SummittDweller/Motorized_MQTT_Blinds/README.md

# Motorized_MQTT_Blinds

This repository is to accompany my Motorized_MQTT_Blinds video:

IMAGE ALT TEXT HERE (https://www.youtube.com/watch?v=1O_1gUFumQM)

## Parts List
Stepper Motors: https://amzn.to/2D5rVsF

Stepper Drivers: https://amzn.to/2OZqW1W

NodeMCU: https://amzn.to/2I89xDF

12V Power Supply: https://amzn.to/2G2ZJrf

Buck Converter: https://amzn.to/2UsQ7jA

## 3D Printing

Download the correct STL file for your style of tilt rod

## Wiring Schematic

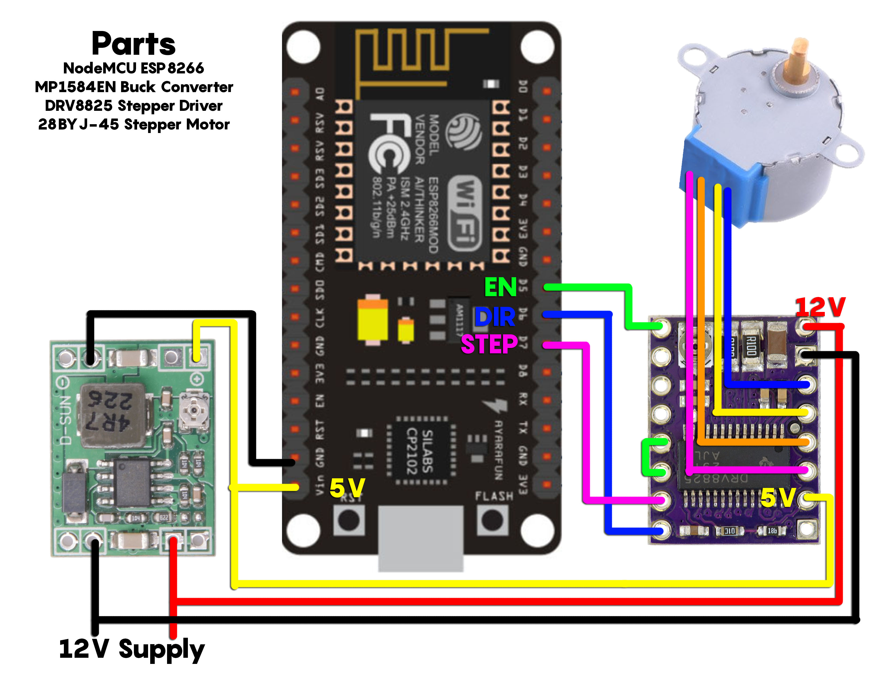
[picture p1: Alexa-Only/Motorized_MQTT_Blinds-Alexa_No_Hub/Schematic.jpg]


**Dont forget to cut the center trace on the stepper motor as shown in the youtube video**

## File setup

Fill out the entire USER CONFIGURATION section of the code.

You should leave "STEPS_TO_CLOSE" at 12 to start with.  It can be adjusted for your specific blinds

## Home Assistant YAML

Replace "BlindsMCU" with your MQTT_CLIENT_ID if you changed it in the file setup

```yaml
cover:
  - platform: mqtt
    name: "Motorized Blinds"
    command_topic: "BlindsMCU/blindsCommand"
    set_position_topic: "BlindsMCU/positionCommand"
    position_topic: "BlindsMCU/positionState"
    state_topic: "BlindsMCU/positionState"
    retain: true
    payload_open: "OPEN"
    payload_close: "CLOSE"
    payload_stop: "STOP"
    position_open: 0
    position_closed: 12
  ```

## Recommended Tools

Ender3 3d Printer: https://amzn.to/2GcznnZ

Dupont Crimper and Connector Set: https://amzn.to/2X1Oeap

## Alexa only support available in the releases tab of this repo!

# Additional Resources

## DRV8825 Stepper Motor Driver Chip
https://lastminuteengineers.com/drv8825-stepper-motor-driver-arduino-tutorial/

## Dupont Connector Guide
https://www.instructables.com/Make-a-Good-Dupont-Pin-Crimp-EVERY-TIME/

##  MQTT Server Creation
https://www.google.com/search?client=firefox-b-1-d&q=mqtt+server
https://www.home-assistant.io/docs/mqtt/broker/
https://learn.adafruit.com/set-up-home-assistant-with-a-raspberry-pi/raspberry-pi-server-setup
https://learn.adafruit.com/set-up-home-assistant-with-a-raspberry-pi/mqtt-setup

## Home Assistant Configuration
http://homeassistant.local:8123        -- My Home Assitant, an RPI B+ located in my office closet
https://www.home-assistant.io/getting-started/onboarding/

### NodeMCU (Arduino) Info

MAC Address of 1st NodeMCU:  84:CC:A8:82:DE:0A

**Attention!** Make sure you are using a micro-USB cable that supports _*data*_ as well as power!

Note that there are comm port issues with Big Sur that impact Arduino.  For more info see:
https://github.com/esp8266/Arduino/issues/7763 and the fix in https://forum.arduino.cc/index.php?topic=702144.0.

#### NodeMCU and Alexa
https://www.instructables.com/How-To-DIY-Home-Automation-With-NodeMCU-and-Amazon/    --not all that helpful
https://randomnerdtutorials.com/alexa-echo-with-esp32-and-esp8266/  --helped with libraries install

#### Now for the Resources
https://www.open-homeautomation.com/2016/06/10/program-an-esp8266-from-arduino-on-macos/
https://en.wikipedia.org/wiki/NodeMCU
https://www.instructables.com/How-to-Program-NodeMCU-on-Arduino-IDE/
https://github.com/nodemcu/nodemcu-firmware
https://medium.com/@bass.pj/nodemcu-esp8266-getting-started-with-arduino-on-macos-1cdc61565496
https://electrosome.com/esp8266-arduino-programming-led-blink/    -- LED blink test

From the Amazon.com product description...

Product description:
ESP8266 is a highly integrated chip designed for the needs of a new connected world. It offers a complete and self-contained Wi-Fi networking solution, allowing it to either host the application or to offload all Wi-Fi networking functions from another application processor.

Instruction & Steps of How to Use:

1. Download the Arduino IDE, the latest version.
2. Install the IDE
3. Set up your Arduino IDE as: Go to File->Preferences and copy the URL below to get the ESP board manager extensions: http://arduino.esp8266.com/stable/package_esp8266com_index.json Placing the http:// before the URL lets the Arduino IDE use it...otherwise it gives you a protocol error.
4. Go to Tools > Board > Board Manager> Type "esp8266" and download the Community esp8266 and install.
5. Set up your chip as:
Tools -> Board -> NodeMCU 1.0 (ESP-12E Module)
Tools -> Flash Size -> 4M (3M SPIFFS)
Tools -> CPU Frequency -> 80 Mhz
Tools -> Upload Speed -> 921600
Tools-->Port--> (whatever it is)
6. Download and run the 32 bit flasher exe at Github(Search for nodemcu/nodemcu-flasher/tree/master/ at Github) github.com/nodemcu/nodemcu-flasher/tree/master/Win32/Release Or download and run the 64 bit flasher exe at: github.com/nodemcu/nodemcu-flasher/tree/master/Win64/Release
7. In Arduino IDE, look for the old fashioned Blink program. Load, compile and upload.
8. Go to FILE> EXAMPLES> ESP8266> BLINK, it will start blinking.

### Control via Arduino Uno
https://www.makerguides.com/28byj-48-stepper-motor-arduino-tutorial/
https://www.seeedstudio.com/blog/2019/03/04/driving-a-28byj-48-stepper-motor-with-a-uln2003-driver-board-and-arduino/
https://lastminuteengineers.com/28byj48-stepper-motor-arduino-tutorial/

### Control via Raspberry Pi
https://www.aranacorp.com/en/control-a-stepper-with-raspberrypi/
http://www.scraptopower.co.uk/Raspberry-Pi/how-to-connect-stepper-motors-a-raspberry-pi
https://www.raspberrypi-spy.co.uk/2012/07/stepper-motor-control-in-python/
https://tutorials-raspberrypi.com/how-to-control-a-stepper-motor-with-raspberry-pi-and-l293d-uln2003a/

# Alexa ONLY Control... the GOOD Stuff

  - Lifted from https://github.com/thehookup/Motorized_MQTT_Blinds/releases/tag/Alexa_No_Hub

## Alexa Only with WiFi Manager

@thehookup thehookup released this on Apr 11, 2019 · 10 commits to master since this release

This release uses Amazon Alexa local control and WiFi Manager to configure and control your blinds. No other hub or device (other than a wifi router) is required for this version and there is no MQTT control.

This is a pre-compiled bin file to upload to a NodeMCU using the ESPEasy flashing tool (instructions below).

  Install Instructions:

      Download the ESPEasy Flashing tool here: https://github.com/letscontrolit/ESPEasy/releases/
      Extract the zip file from the above link to your computer
      Download the .bin file for this release and place it in the same folder as the ESPEasy flashing tool.
      Plug in your NodeMCU using a USB Cable
      Run FlashESP8266.exe
      Select this bin file (Alexa_Only_Blinds.bin) under the firmware dropdown and press "Flash"

  Setup Instructions:

      Connect to the "Blinds Setup" wifi access point that is being broadcast by your NodeMCU
      Enter your WiFi SSID and Password
      Enter the number of rotations required for your blinds to fully open/close (12 Recommended)
      Press save and wire your blinds as shown in the wiring diagram on the main page of this repository.

  **If you mess up your settings you can connect a wire between GND and D1 to clear the saved settings on the NodeMCU.
  If you have issues with discovery please try the "Blinds_CONFIGURE_Portal_Alexa_Core_2.3.bin" file

  Assets 4
  Alexa_Only_Blinds.bin
  408 KB
  Blinds_CONFIGURE_Portal_Alexa_Core_2.3.bin
  358 KB
  Source code (zip)
  Source code (tar.gz)
