SummittDweller/Motorized_MQTT_Blinds/Cat5-Cable-Colors.md

# Cat5 Cable Colors

In my version of the project the Cat5 cable runs have the following color correspondence:

| Schematic | Cat5 Color | Purpose |
| --- | --- | --- |
| Black | Green | Common |
| Red | Orange Pair | +12v Power |
| Blue | Brown | Direction |
| Magenta | Brown/White | Step |
| Green | Blue | Enable |
| Yellow | Blue/White | +5v Power |
| --- | Green/White | RPi Logic GND |
