SummittDweller/Motorized_MQTT_Blinds/Alexa-Only/Motorized_MQTT_Blinds-Alexa_No_Hub/BlindsAdapter6mmHex.stl

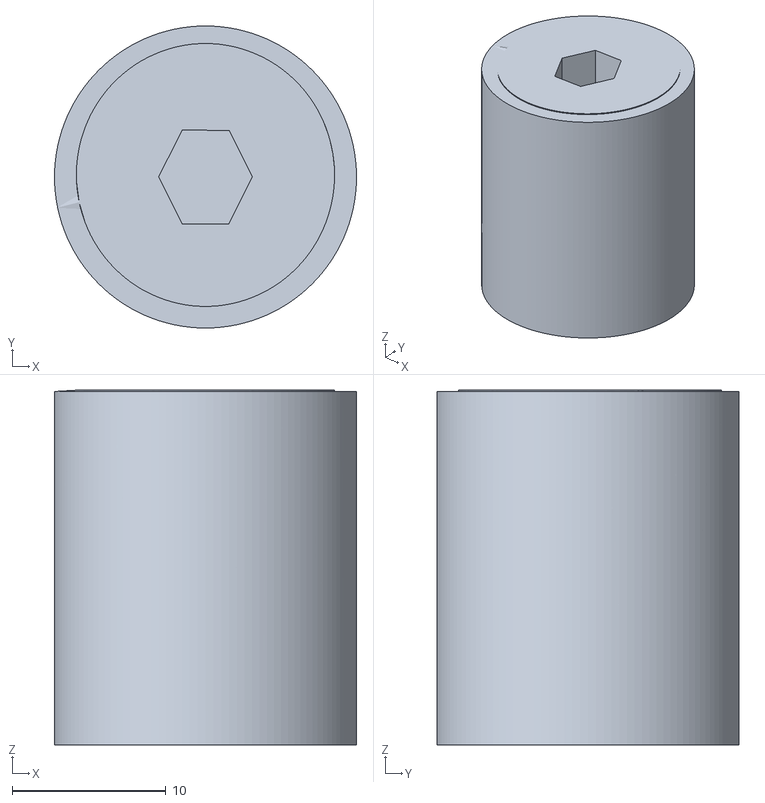
[picture p2: CAD file, 2021-02-14]
Alexa-Only/Motorized_MQTT_Blinds-Alexa_No_Hub/BlindsAdapter6mmHex.stl
19.6 x 19.6 x 23.1
