SummittDweller/Motorized_MQTT_Blinds/Mini-Blind-Motor-Mount-with-Controller-Box.stl

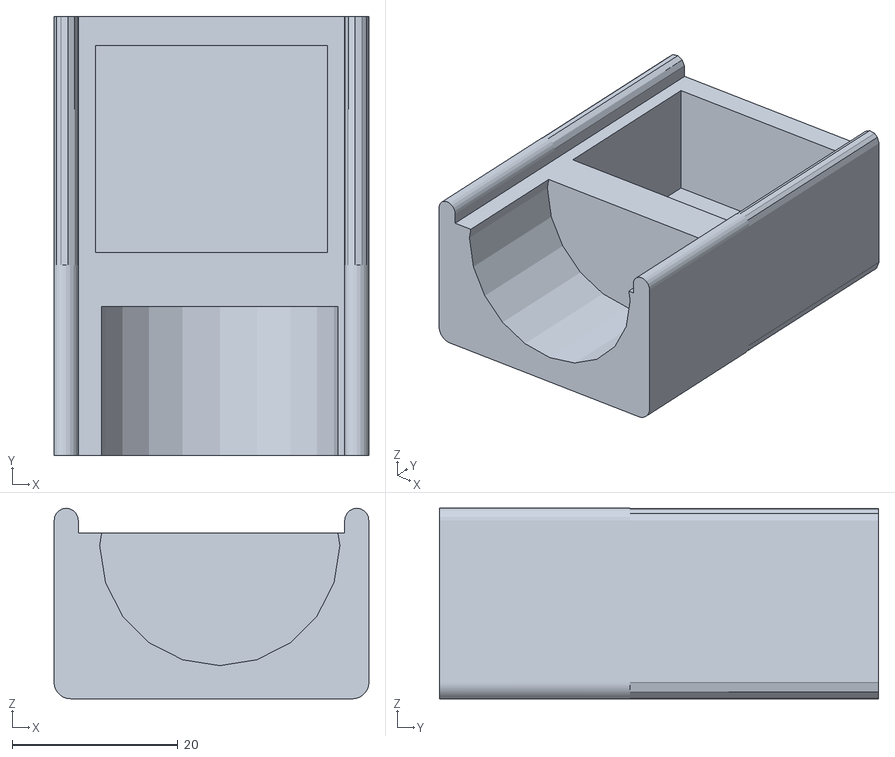
[picture p3: CAD file, 2021-02-20]
Mini-Blind-Motor-Mount-with-Controller-Box.stl
38.0 x 53.0 x 23.0
