SummittDweller/Motorized_MQTT_Blinds/Mini-Blind-Controller-Box-Only.stl

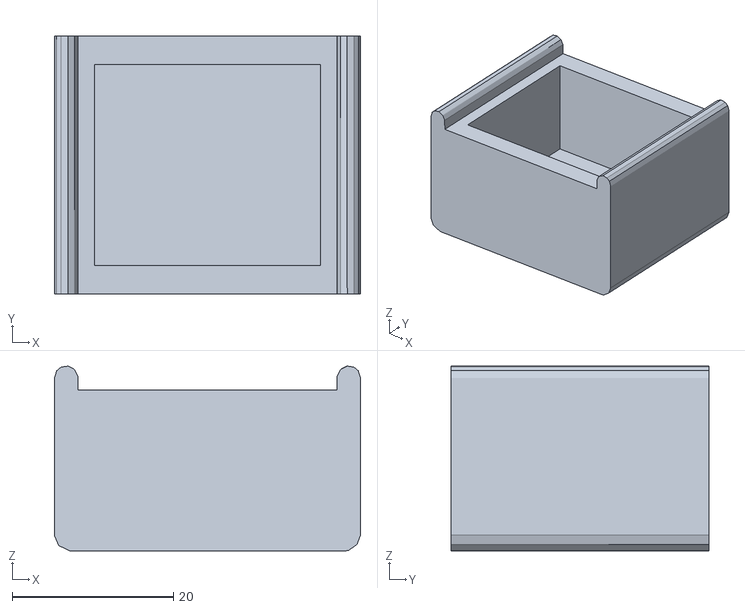
[picture p5: CAD file, 2021-02-17]
Mini-Blind-Controller-Box-Only.stl
38.0 x 32.0 x 23.0
