SummittDweller/Motorized_MQTT_Blinds/Alexa-Only/Motorized_MQTT_Blinds-Alexa_No_Hub/BlindsBase.stl

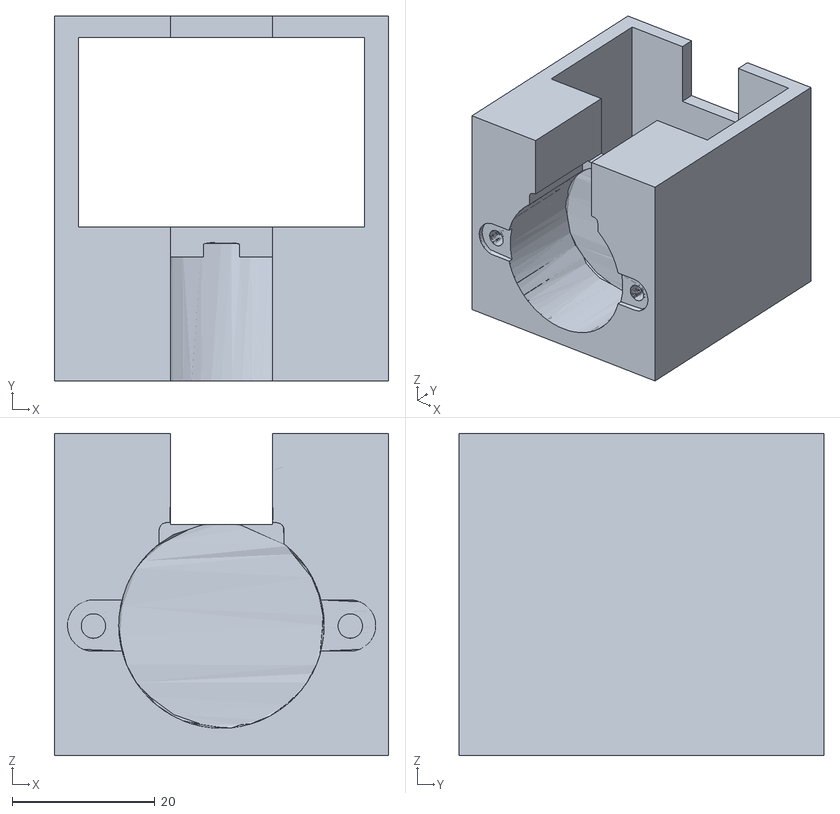
[picture p6: CAD file, 2021-02-14]
Alexa-Only/Motorized_MQTT_Blinds-Alexa_No_Hub/BlindsBase.stl
46.8 x 51.1 x 45.1
