SummittDweller/Motorized_MQTT_Blinds/(list of files, cad)

Other CAD files:
Alexa-Only/Motorized_MQTT_Blinds-Alexa_No_Hub/BlindsAdapter4mmSquare.stl
Alexa-Only/Motorized_MQTT_Blinds-Alexa_No_Hub/BlindsAdapter5mmSquare.stl
