SummittDweller/Motorized_MQTT_Blinds/CAT5-Colors-Motor-Control-Wiring.png

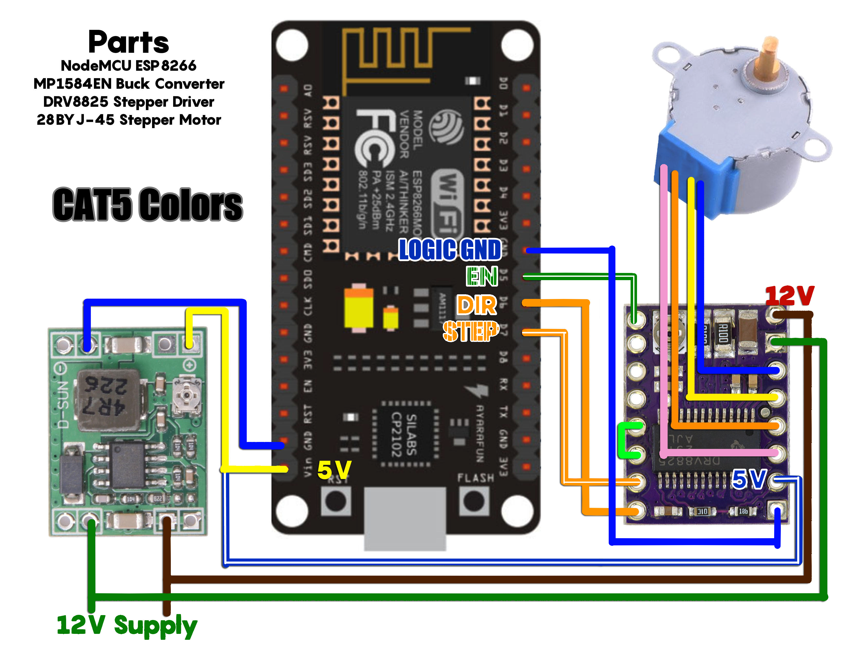
CAT5-Colors-Motor-Control-Wiring.png
