SummittDweller/Motorized_MQTT_Blinds/Fine-Adjust-Using-RPI/Hrisko.py

#######################################
# Copyright (c) 2021 Maker Portal LLC
# Author: Joshua Hrisko
#######################################
#
# NEMA 17 (17HS4023) Raspberry Pi Tests
# --- rotating the NEMA 17 to test
# --- wiring and motor functionality
#
## Lifted from https://makersportal.com/blog/raspberry-pi-stepper-motor-control-with-nema-17
##   with pin modifications per my wiring.
#
#######################################
#
import RPi.GPIO as GPIO
from RpiMotorLib import RpiMotorLib
import time

################################
# RPi and Motor Pre-allocations
################################
#
#define GPIO pins
direction = 24 # Direction (DIR) GPIO Pin
step = 23 # Step GPIO Pin
EN_pin = 12 # enable pin (LOW to enable)

# Declare a instance of class pass GPIO pins numbers and the motor type
mymotortest = RpiMotorLib.A4988Nema(direction, step, (21,21,21), "DRV8825")
GPIO.setup(EN_pin,GPIO.OUT) # set enable pin as output

###########################
# Actual motor control
###########################
#
GPIO.output(EN_pin,GPIO.LOW) # pull enable to low to enable motor
mymotortest.motor_go(False, # True=Clockwise, False=Counter-Clockwise
                     "Full" , # Step type (Full,Half,1/4,1/8,1/16,1/32)
                     200, # number of steps
                     .0005, # step delay [sec]
                     False, # True = print verbose output 
                     .05) # initial delay [sec]

GPIO.cleanup() # clear GPIO allocations after run
