SummittDweller/Motorized_MQTT_Blinds/(commit log)

2021-02-04 Added stepper motor 5v project list
2021-02-04 Added RPI stepper motor projects
2021-02-09 Added Dupont connector guide...invaluable
2021-02-13 Added Arduino libraries
2021-02-14 Added DRV8825 driver section
2021-02-14 More Alexa info and files
    [BlindsAdapter4mmSquare.stl, BlindsAdapter5mmHex.stl, BlindsAdapter5mmSquare.stl, BlindsAdapter6mmHex.stl, BlindsBase.stl]
2021-02-17 Added schematic with CAT5 colors
2021-02-17 New .stl builds
    [Mini-Blind-Controller-Box-Only.stl, Mini-Blind-Motor-Mount-with-Controller-Box.stl]
2021-02-18 Added 3d print files
    [Mini-Blind-Motor-Mount-with-Controller-Box.stl]
2021-02-20 Updated 3d print assets
2021-02-24 Updated schematic with CAT5 colors
2021-02-26 Added 4-wire CAT5 colors description
